BiOflab/Incubascope/200825_stamp_resized.STL

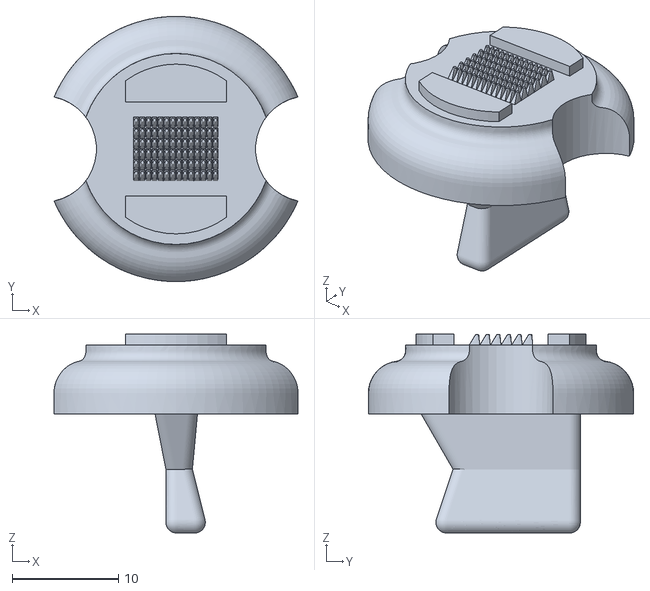
[picture p1: CAD file, 2021-11-14]
200825_stamp_resized.STL
23.0 x 25.0 x 18.8
