BiOflab/Incubascope/210206_stamp_shrimps_cam2.STL

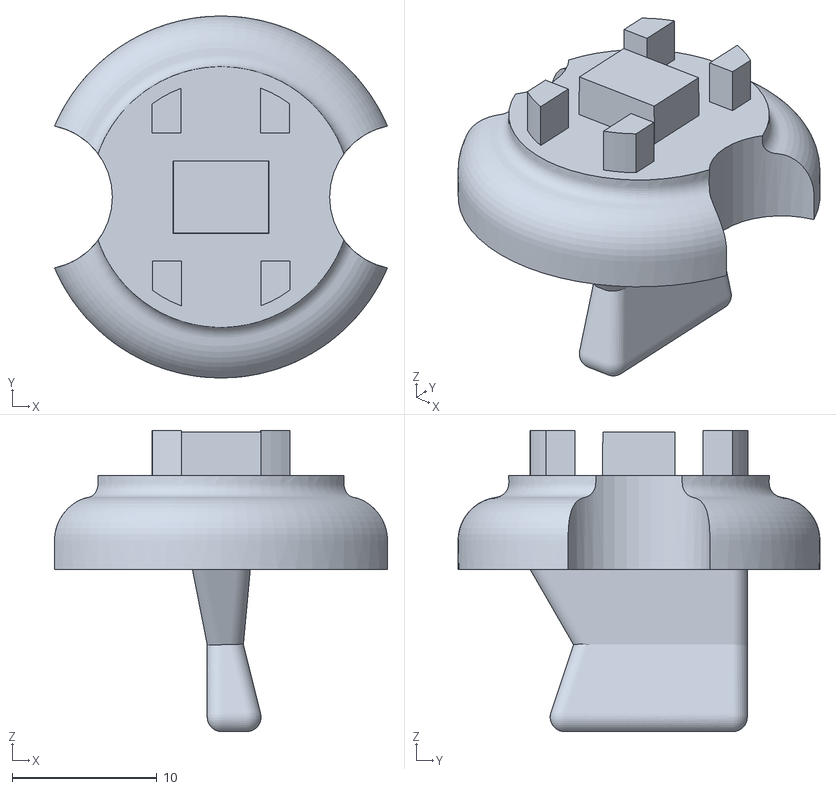
[picture p2: CAD file, 2021-11-14]
210206_stamp_shrimps_cam2.STL
23.0 x 25.0 x 20.8
